hggh/led-matrix-clock/README.md

# dot matrix display clock

reto dot matrix clock with LiteOn LTP-305 with three IS31FL3730

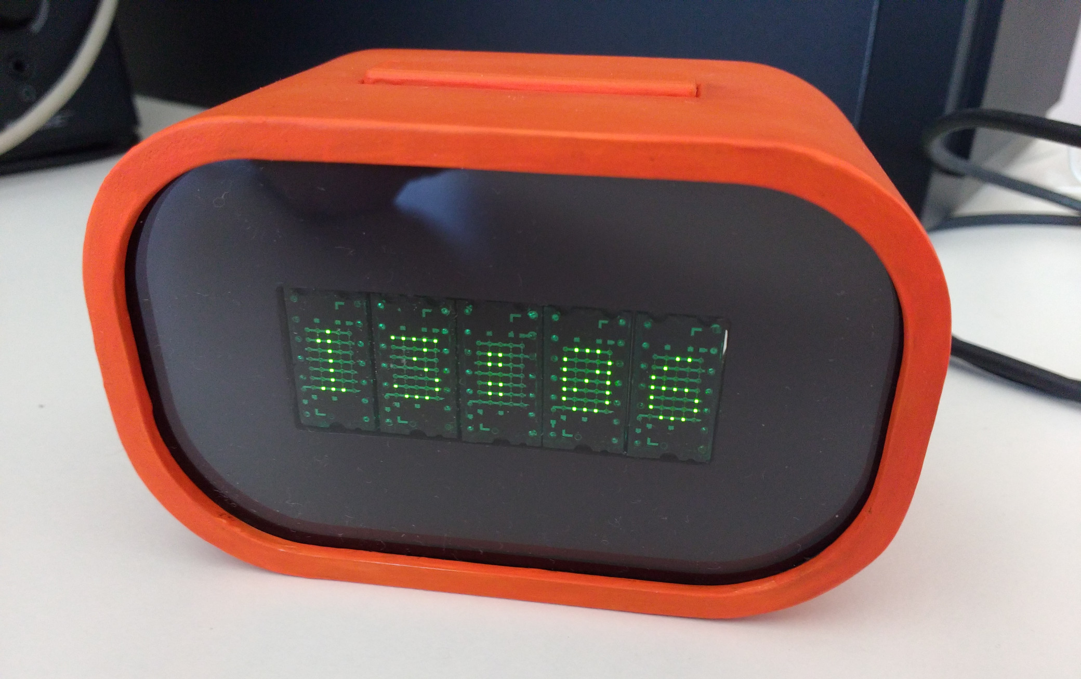
[picture p1: pics/clock-case.jpg]

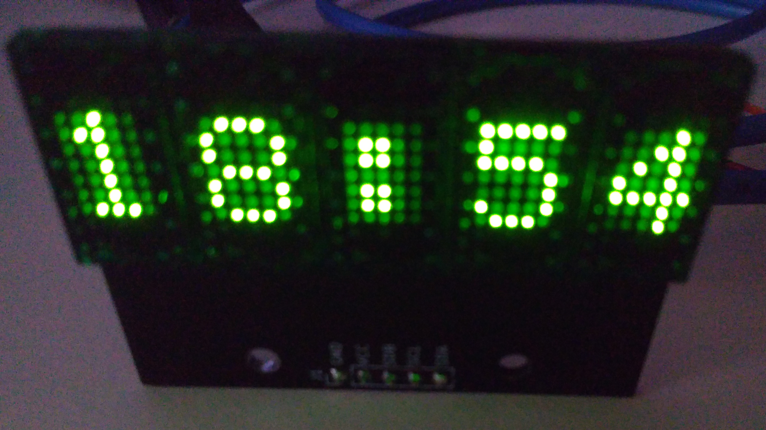
[picture p2: pics/clock-base.jpg]
