hggh/led-matrix-clock/case/usb-c-breakout-case-holder.stl

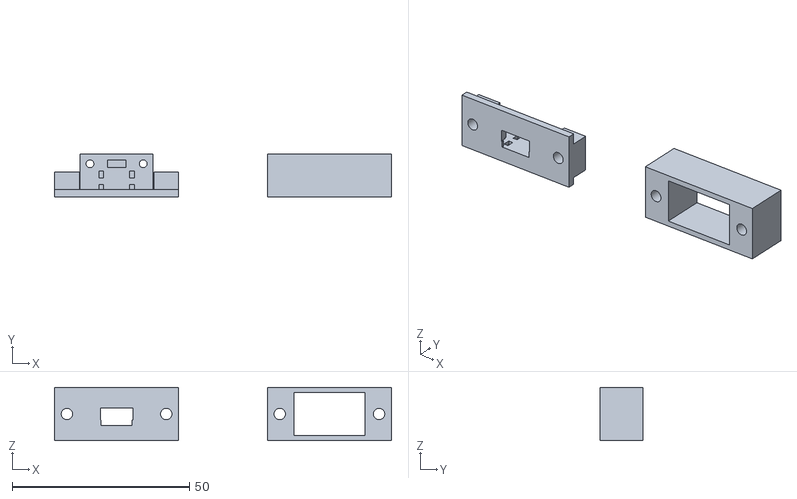
[picture p3: CAD file, 2022-02-08]
case/usb-c-breakout-case-holder.stl
95.0 x 12.0 x 15.0
