hggh/led-matrix-clock/case/case.stl

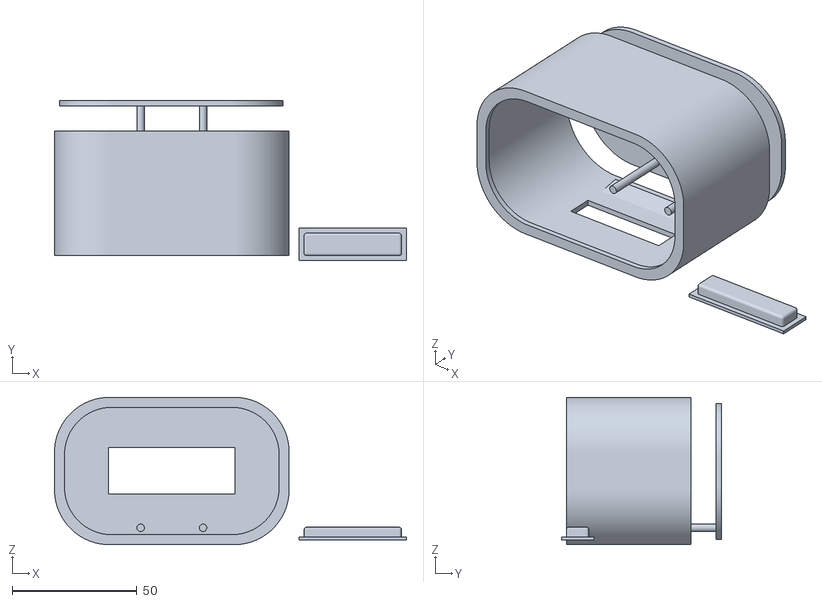
[picture p4: CAD file, 2021-10-15]
case/case.stl
141.0 x 64.2 x 59.0
