hggh/led-matrix-clock/pcb/usb-c-breakout/usb-c-breakout.kicad_pcb

## KiCad design pcb/usb-c-breakout/usb-c-breakout.kicad_pcb (2021-12-02)

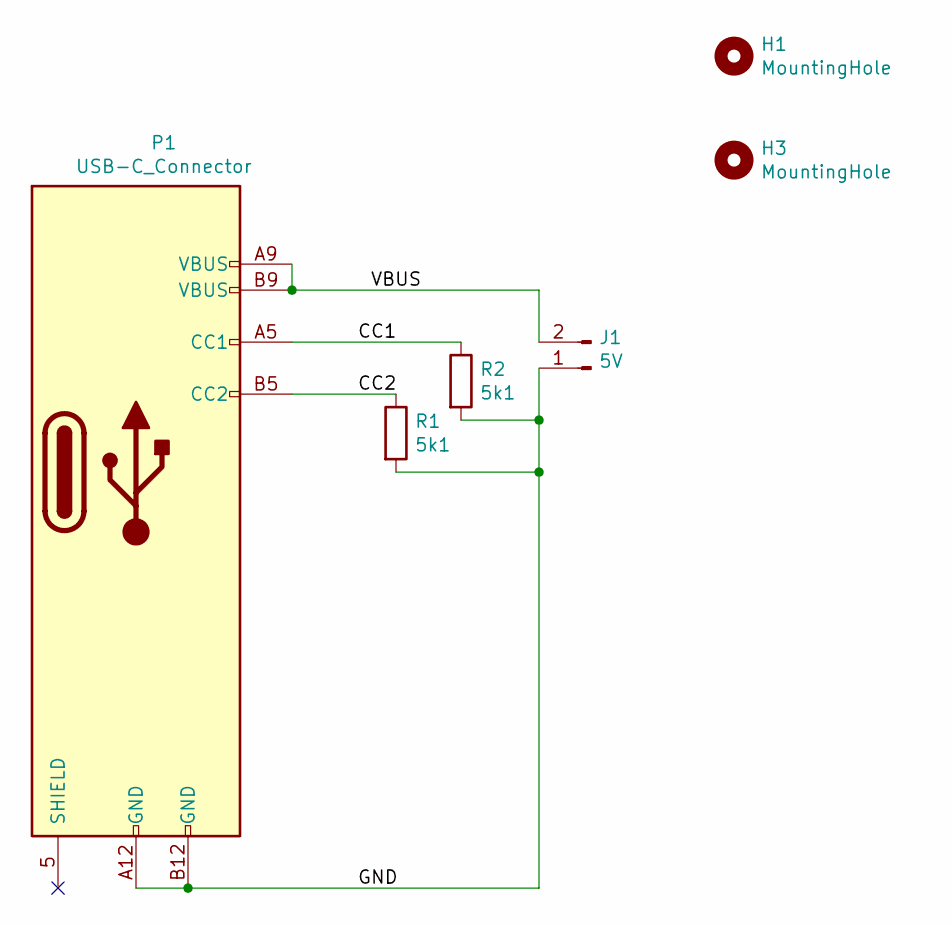
[picture p5: schematic usb-c-breakout.sch]

Parts:
H1, H3: MountingHole; MountingHole_2.2mm_M2
J1: 5V; PinHeader_1x02_P2.00mm_Vertical
P1: USB-C_Connector; USB-C Connector
R1, R2: 5k1; R_0805_2012Metric

Connections:
/CC1: P1.A5 (CC1), R2.1
/CC2: P1.B5 (CC2), R1.1
/GND: J1.1, P1.A12 (GND), P1.B12 (GND), R1.2, R2.2
/VBUS: J1.2, P1.A9 (VBUS), P1.B9 (VBUS)

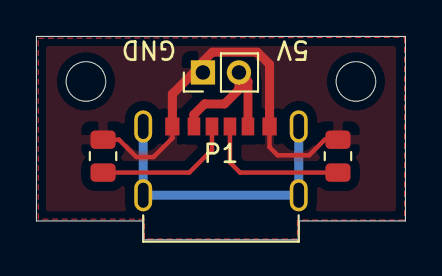
[picture p6: board usb-c-breakout.kicad_pcb from above]

Board: 2 copper layers, 20.5 x 11.3 mm, 6 parts (0 on the bottom side), 4 nets.
