hggh/led-matrix-clock/pcb/clock-base/clock-base.kicad_pcb

## KiCad design pcb/clock-base/clock-base.kicad_pcb (2021-09-22)

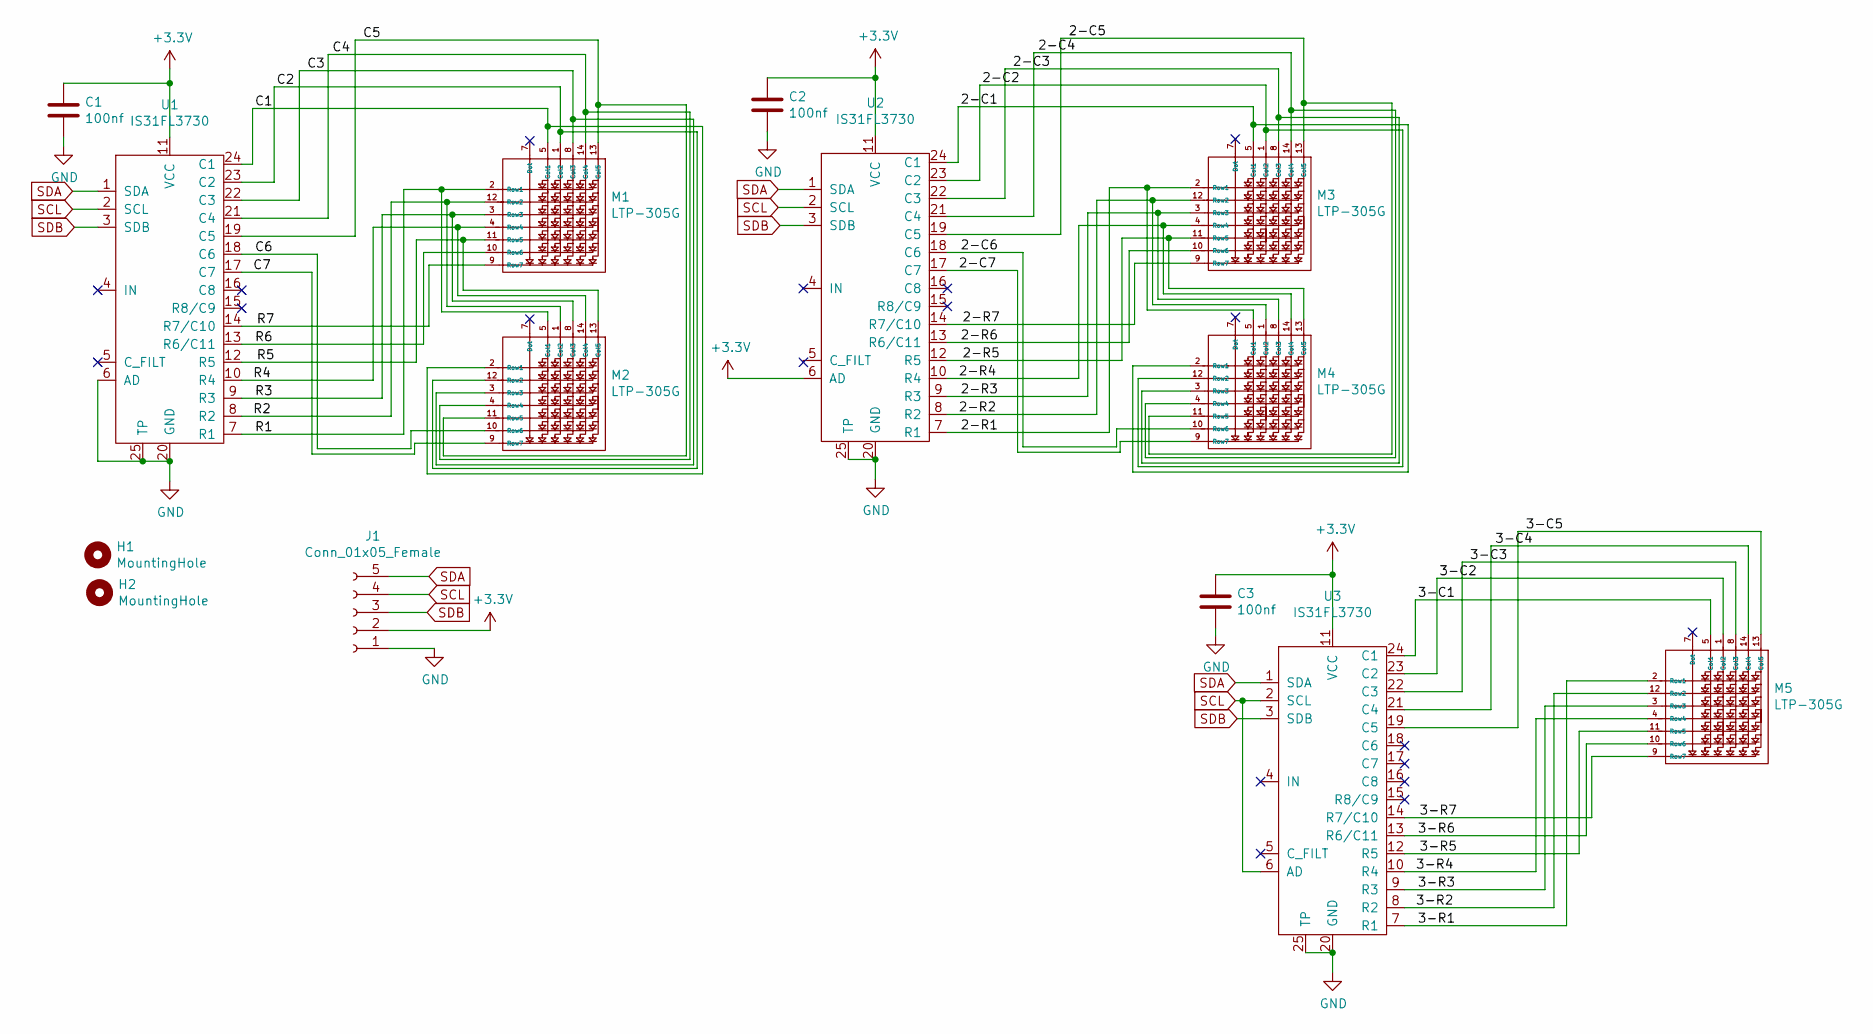
[picture p7: schematic clock-base.sch]

Parts:
C1, C2, C3: 100nf; C_0805_2012Metric
H1, H2: MountingHole; MountingHole_3.2mm_M3
J1: Conn_01x05_Female; PinHeader_1x05_P2.54mm_Vertical
M1, M2, M3, M4, M5: LTP-305G
U1, U2, U3: IS31FL3730; QFN-24-1EP_4x4mm_P0.5mm_EP2.6x2.6mm

Connections:
+3V3: C1.1, C2.1, C3.1, J1.2, U1.11 (VCC), U2.6 (AD), U2.11 (VCC), U3.11 (VCC)
/2-C1: M3.5 (Col1), M4.2 (Row1), U2.24 (C1)
/2-C2: M3.1 (Col2), M4.12 (Row2), U2.23 (C2)
/2-C3: M3.8 (Col3), M4.3 (Row3), U2.22 (C3)
/2-C4: M3.14 (Col4), M4.4 (Row4), U2.21 (C4)
/2-C5: M3.13 (Col5), M4.11 (Row5), U2.19 (C5)
/2-C6: M4.10 (Row6), U2.18 (C6)
/2-C7: M4.9 (Row7), U2.17 (C7)
/2-R1: M3.2 (Row1), M4.5 (Col1), U2.7 (R1)
/2-R2: M3.12 (Row2), M4.1 (Col2), U2.8 (R2)
/2-R3: M3.3 (Row3), M4.8 (Col3), U2.9 (R3)
/2-R4: M3.4 (Row4), M4.14 (Col4), U2.10 (R4)
/2-R5: M3.11 (Row5), M4.13 (Col5), U2.12 (R5)
/2-R6: M3.10 (Row6), U2.13 (R6/C11)
/2-R7: M3.9 (Row7), U2.14 (R7/C10)
/3-C1: M5.5 (Col1), U3.24 (C1)
/3-C2: M5.1 (Col2), U3.23 (C2)
/3-C3: M5.8 (Col3), U3.22 (C3)
/3-C4: M5.14 (Col4), U3.21 (C4)
/3-C5: M5.13 (Col5), U3.19 (C5)
/3-R1: M5.2 (Row1), U3.7 (R1)
/3-R2: M5.12 (Row2), U3.8 (R2)
/3-R3: M5.3 (Row3), U3.9 (R3)
/3-R4: M5.4 (Row4), U3.10 (R4)
/3-R5: M5.11 (Row5), U3.12 (R5)
/3-R6: M5.10 (Row6), U3.13 (R6/C11)
/3-R7: M5.9 (Row7), U3.14 (R7/C10)
/C1: M1.5 (Col1), M2.2 (Row1), U1.24 (C1)
/C2: M1.1 (Col2), M2.12 (Row2), U1.23 (C2)
/C3: M1.8 (Col3), M2.3 (Row3), U1.22 (C3)
/C4: M1.14 (Col4), M2.4 (Row4), U1.21 (C4)
/C5: M1.13 (Col5), M2.11 (Row5), U1.19 (C5)
/C6: M2.10 (Row6), U1.18 (C6)
/C7: M2.9 (Row7), U1.17 (C7)
/R1: M1.2 (Row1), M2.5 (Col1), U1.7 (R1)
/R2: M1.12 (Row2), M2.1 (Col2), U1.8 (R2)
/R3: M1.3 (Row3), M2.8 (Col3), U1.9 (R3)
/R4: M1.4 (Row4), M2.14 (Col4), U1.10 (R4)
/R5: M1.11 (Row5), M2.13 (Col5), U1.12 (R5)
/R6: M1.10 (Row6), U1.13 (R6/C11)
/R7: M1.9 (Row7), U1.14 (R7/C10)
GND: C1.2, C2.2, C3.2, J1.1, U1.6 (AD), U1.20 (GND), U1.25 (TP), U2.20 (GND), U2.25 (TP), U3.20 (GND), U3.25 (TP)
SCL: J1.4, U1.2 (SCL), U2.2 (SCL), U3.2 (SCL), U3.6 (AD)
SDA: J1.5, U1.1 (SDA), U2.1 (SDA), U3.1 (SDA)
SDB: J1.3, U1.3 (SDB), U2.3 (SDB), U3.3 (SDB)

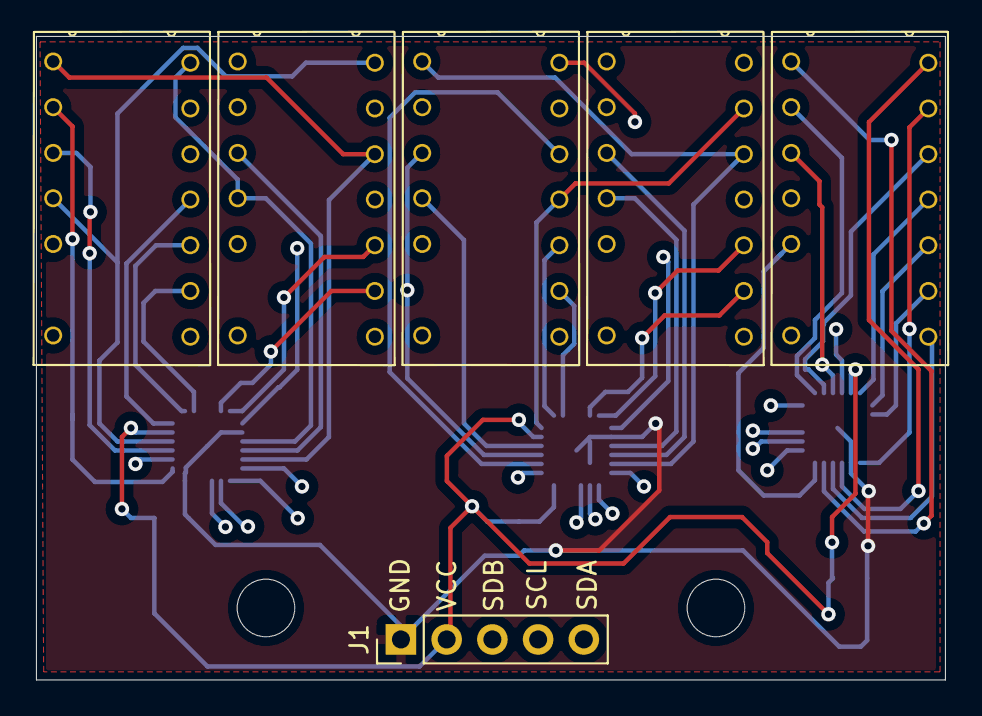
[picture p8: board clock-base.kicad_pcb from above]

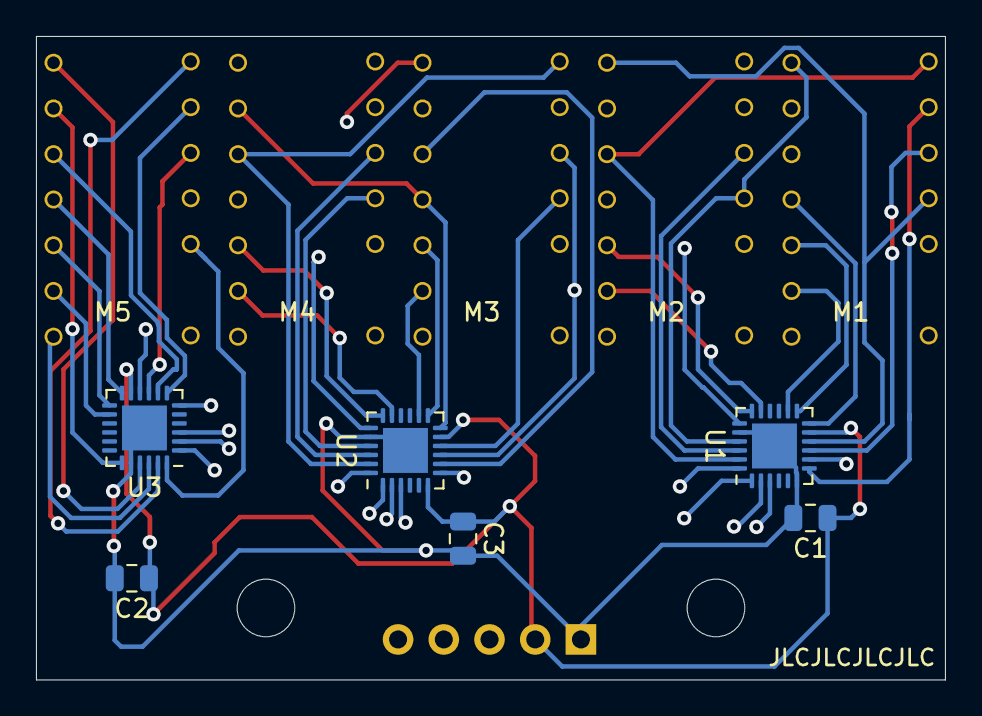
[picture p9: board clock-base.kicad_pcb from below]

Board: 4 copper layers, 50.5 x 35.8 mm, 14 parts (6 on the bottom side), 45 nets.
