hggh/led-matrix-clock/include/chars.h

static uint8_t char_5x7_A[7][5] = {
    {0, 1, 1, 1, 0},
    {1, 0, 0, 0, 1},
    {1, 0, 0, 0, 1},
    {1, 0, 0, 0, 1},
    {1, 1, 1, 1, 1},
    {1, 0, 0, 0, 1},
    {1, 0, 0, 0, 1},
};

static uint8_t char_5x7_B[7][5] = {
    {1, 1, 1, 1, 0},
    {1, 0, 0, 0, 1},
    {1, 0, 0, 0, 1},
    {1, 1, 1, 1, 0},
    {1, 0, 0, 0, 1},
    {1, 0, 0, 0, 1},
    {1, 1, 1, 1, 0},
};

static uint8_t char_5x7_C[7][5] = {
    {0, 1, 1, 1, 0},
    {1, 0, 0, 0, 1},
    {1, 0, 0, 0, 0},
    {1, 0, 0, 0, 0},
    {1, 0, 0, 0, 0},
    {1, 0, 0, 0, 1},
    {0, 1, 1, 1, 0},
};

static uint8_t char_5x7_D[7][5] = {
    {1, 1, 1, 0, 0},
    {1, 0, 0, 1, 0},
    {1, 0, 0, 0, 1},
    {1, 0, 0, 0, 1},
    {1, 0, 0, 0, 1},
    {1, 0, 0, 1, 0},
    {1, 1, 1, 0, 0},
};

static uint8_t char_5x7_E[7][5] = {
    {1, 1, 1, 1, 1},
    {1, 0, 0, 0, 0},
    {1, 0, 0, 0, 0},
    {1, 1, 1, 1, 0},
    {1, 0, 0, 0, 0},
    {1, 0, 0, 0, 0},
    {1, 1, 1, 1, 1},
};

static uint8_t char_5x7_F[7][5] = {
    {1, 1, 1, 1, 1},
    {1, 0, 0, 0, 0},
    {1, 0, 0, 0, 0},
    {1, 1, 1, 0, 0},
    {1, 0, 0, 0, 0},
    {1, 0, 0, 0, 0},
    {1, 0, 0, 0, 0},
};

static uint8_t char_5x7_G[7][5] = {
    {0, 1, 1, 1, 0},
    {1, 0, 0, 0, 1},
    {1, 0, 0, 0, 0},
    {1, 0, 0, 0, 0},
    {1, 0, 0, 1, 1},
    {1, 0, 0, 0, 1},
    {0, 1, 1, 1, 0},
};

static uint8_t char_5x7_H[7][5] = {
    {1, 0, 0, 0, 1},
    {1, 0, 0, 0, 1},
    {1, 0, 0, 0, 1},
    {1, 1, 1, 1, 1},
    {1, 0, 0, 0, 1},
    {1, 0, 0, 0, 1},
    {1, 0, 0, 0, 1},
};

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
    {1, 0, 0, 0, 1},
    {1, 0, 0, 0, 1},
    {0, 1, 1, 1, 0},
    {1, 0, 0, 0, 1},
    {1, 0, 0, 0, 1},
    {0, 1, 1, 1, 0},
  },
  { // 9
    {0, 1, 1, 1, 0},
    {1, 0, 0, 0, 1},
    {1, 0, 0, 0, 1},
    {0, 1, 1, 1, 1},
    {0, 0, 0, 0, 1},
    {0, 0, 0, 1, 0},
    {0, 1, 1, 0, 0},
  },
};
