hggh/led-matrix-clock/(commit log)

2021-09-22 ordered version
    [clock-base.kicad_pcb, clock-base.sch]
2021-10-10 basic esp32 clock code
2021-10-10 add pin mapping on esp32
2021-10-11 add case 1. version
    [case.scad, case.stl]
2021-10-11 update to case
    [case.scad, case.stl]
2021-10-15 updated case
    [case.scad, case.stl]
2021-10-21 add holder - needs testing
    [case.scad]
2021-12-02 add usb-c breakout
    [usb-c-breakout.kicad_pcb, usb-c-breakout.sch]
2022-01-11 add case for USB-C breakout
    [usb-c-breakout-case-holder.scad, usb-c-breakout-case-holder.stl]
2022-01-11 update stl
    [usb-c-breakout-case-holder.stl]
2022-02-08 update case to fit pcb
    [usb-c-breakout-case-holder.scad, usb-c-breakout-case-holder.stl]
2022-02-11 add case pic
